wtlllll190812/Sphygmus/README.md

主工程文件在 Keil 中

Matlab 中为用于显示 adc 采样波形的程序

PCB 中为项目的原理图文件和 PCB 文件

报告以及一些实验结果在“报告等”文件夹中

使用注意：

1. 为避免误启动，手放置到传感器上时可能需要一段时间才可以显示
2. 蓝牙模块可能会干扰传感器，不用时可拔出，具体原因未知。
3. 心率为实时显示，但会求 60 次心跳的平均值，所以需要测量一段时间才会稳定下来
