wtlllll190812/Sphygmus/报告/result.xlsx

波形数据 | 心率
2207 | 104.167
2397 | 104.167
2654 | 104.167
2730 | 104.167
2735 | 104.167
2738 | 104.167
2742 | 94.4882
2735 | 94.4882
2740 | 94.4882
2745 | 94.4882
2739 | 94.4882
2739 | 94.4882
2735 | 94.4882
2740 | 94.4882
2745 | 94.4882
2735 | 94.4882
2139 | 94.4882
1147 | 94.4882
449 | 94.4882
106 | 94.4882
111 | 94.4882
239 | 94.4882
430 | 94.4882
739 | 94.4882
1181 | 94.4882
1580 | 94.4882
2063 | 94.4882
2350 | 94.4882
2531 | 94.4882
2678 | 94.4882
2739 | 94.4882
2734 | 100.334
2715 | 100.334
2739 | 100.334
2739 | 100.334
2738 | 100.334
2730 | 100.334
2738 | 100.334
2715 | 100.334
2693 | 100.334
2715 | 100.334
2678 | 100.334
2738 | 100.334
2736 | 100.334
2737 | 100.334
2706 | 100.334
2739 | 100.334
2745 | 100.334
2473 | 100.334
1448 | 100.334
585 | 100.334
104 | 100.334
63 | 100.334
160 | 100.334
380 | 100.334
714 | 100.334
1154 | 100.334
1728 | 100.334
2329 | 100.334
2744 | 100.334
2740 | 100.334
2735 | 100.334
2739 | 100.334
2738 | 100.334
2747 | 99.7921
2742 | 99.7921
2743 | 99.7921
2742 | 99.7921
2718 | 99.7921
2738 | 99.7921
2739 | 99.7921
2743 | 99.7921
2738 | 99.7921
2742 | 99.7921
2734 | 99.7921
2730 | 99.7921
2747 | 99.7921
2744 | 99.7921
2745 | 99.7921
2692 | 99.7921
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
