wtlllll190812/Sphygmus/(list of files, drawings)

Other design files:
PCB/PCB1.PcbDoc
PCB/Sheet1.SchDoc
