wtlllll190812/Sphygmus/Keil/sphygmus.ioc

Mcu.UserName=STM32F103C8Tx
PA10.Signal=USART1_RX
PA13.Signal=SYS_JTMS-SWDIO
PA14.Signal=SYS_JTCK-SWCLK
PA2.Signal=USART2_TX
PA3.Signal=USART2_RX
PA9.Signal=USART1_TX
PB0.Signal=ADCx_IN8
PB11.Signal=GPXTI11
PB6.Signal=I2C1_SCL
PB7.Signal=I2C1_SDA
PB8.GPIO_Label=Alarm
PB8.Signal=GPIO_Output
