wtlllll190812/Sphygmus/plot.ini

[MainWindow]
size=@Size(804 650)
pos=@Point(632 142)
activePanel=Plot
hidePanels=false
maximized=false
state=@ByteArray(\0\0\0\xff\0\0\0\0\xfd\0\0\0\0\0\0\x3$\0\0\x2\x39\0\0\0\x4\0\0\0\x4\0\0\0\b\0\0\0\b\xfc\0\0\0\x1\0\0\0\x2\0\0\0\x3\0\0\0\f\0t\0\x62\0P\0l\0o\0t\x1\0\0\0\0\xff\xff\xff\xff\0\0\0\0\0\0\0\0\0\0\0\x1a\0t\0\x62\0P\0o\0r\0t\0\x43\0o\0n\0t\0r\0o\0l\x1\0\0\x1\v\xff\xff\xff\xff\0\0\0\0\0\0\0\0\0\0\0\x10\0t\0\x62\0R\0\x65\0\x63\0o\0r\0\x64\x1\0\0\x2\x81\xff\xff\xff\xff\0\0\0\0\0\0\0\0)

[Port]
selectedPort=COM9
baudRate=115200
parity=none
dataBits=8
stopBits=1
flowControl=none

[DataFormat]
format=ascii

[DataFormat_Binary]
numOfChannels=1
numberFormat=uint8
endianness=little

[DataFormat_ASCII]
numOfChannels=auto
delimiter=","
customDelimiter=","

[DataFormat_CustomFrame]
numOfChannels=1
numberFormat=uint8
endianness=little
frameStart=AA BB
fixedSize=false
frameSize=1
checksum=false
debugMode=false

[Channels]
channel\1\name=Channel 1
channel\1\color=@Variant(\0\0\0\x43\x1\xff\xff\xff\xff\0\0VV\0\0)
channel\1\visible=true
channel\2\name=Channel 2
channel\2\color=@Variant(\0\0\0\x43\x1\xff\xff~~--\xd2\xd2\0\0)
channel\2\visible=true
channel\3\name=Channel 3
channel\3\color=@Variant(\0\0\0\x43\x1\xff\xff\0\0\xae\xae~~\0\0)
channel\3\visible=true
channel\4\name=Channel 4
channel\4\color=@Variant(\0\0\0\x43\x1\xff\xff\xfe\xfe\x89\x89\0\0\0\0)
channel\4\visible=true
channel\5\name=Channel 5
channel\5\color=@Variant(\0\0\0\x43\x1\xff\xff\xff\xff\x93\x93~~\0\0)
channel\5\visible=true
channel\6\name=Channel 6
channel\6\color=@Variant(\0\0\0\x43\x1\xff\xffjj\x82\x82ll\0\0)
channel\6\visible=true
channel\size=6

[Plot]
numOfSamples=1000
plotWidth=1000
indexAsX=true
xMax=1000
xMin=0
autoScale=true
yMax=4095
yMin=0
darkBackground=true
grid=true
minorGrid=true
legend=true
multiPlot=false
symbols=auto

[Commands]
command\1\name=Command 1
command\1\type=ascii
command\1\data=
command\size=1

[Record]
autoIncrement=true
recordPaused=true
stopOnClose=true
header=true
disableBuffering=false
separator=","

[UpdateCheck]
periodicCheck=true
lastCheck=2023-07-11
