wtlllll190812/Sphygmus/(commit log)

2023-07-04 图像正常显示
2023-07-04 上下沿检测
2023-07-04 计时器工作正常
2023-07-06 心率测量成功
    [PCB_Project.PrjPcb]
2023-07-06 正式工程
2023-07-06 最小系统板移植
2023-07-06 oled部分脚本添加
2023-07-07 整合oled代码
2023-07-07 软件模拟iic失败
2023-07-07 继续整合
2023-07-07 延时函数，暂存
2023-07-07 oled成功点亮
2023-07-07 oled显示动画和心率
2023-07-07 使用vscode编程
2023-07-08 oled完全修复
2023-07-08 Merge branch 'hard_iic' into HEAD
    # Conflicts:
    # sphygmus/Core/Src/main.c
    # sphygmus/MDK-ARM/sphygmus/adc.o
    # sphygmus/MDK-ARM/sphygmus/font.o
    # sphygmus/MDK-ARM/sphygmus/gpio.o
    # sphygmus/MDK-ARM/sphygmus/i2c.o
    # sphygmus/MDK-ARM/sphygmus/iic.crf
    # sphygmus/MDK-ARM/sphygmus/iic.o
    # sphygmus/MDK-ARM/sphygmus/main.crf
    # sphygmus/MDK-ARM/sphygmus/main.o
    # sphygmus/MDK-ARM/sphygmus/oled.crf
    # sphygmus/MDK-ARM/sphygmus/oled.o
    # sphygmus/MDK-ARM/sphygmus/sphygmus.axf
    # sphygmus/MDK-ARM/sphygmus/sphygmus.build_log.htm
    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
2023-07-08 iic的delay_us值修改
2023-07-08 中文乱码修复
2023-07-08 中文乱码
2023-07-08 蓝牙输出心率成功
2023-07-08 系统联合调试
2023-07-08 整体测试
2023-07-08 自动开机与关机
2023-07-10 正式版本
2023-07-10 心率平稳化
2023-07-10 稳定点了
2023-07-11 第三方串口软件显示波形
2023-07-11 串口配置
2023-07-12 matlab速度优化
2023-07-12 最终版本
    [result.csv, result.xlsx]
2023-07-13 一些实验结果
    [result.csv, result.xlsx]
2023-07-13 整理文件夹结构
    [PCB1.PcbDoc, PCB_Project.PrjPcb, Sheet1.SchDoc, result.csv, result.xlsx]
2023-07-13 添加README文件
2023-07-13 流程图绘制
2023-07-13 报告提交
    [result.csv]
